dragonet80/MinisumoEdu/README.md

# MinisumoEdu
Robot de minisumo amb finalitats educatives.

De moment, hi ha els arxius en format Eagle de les plaques i les peces en 3D en format Sketchup.

Falten exemples software.
**Pendent de pujar tots els arxius i organitzar-ho tot**
