dragonet80/MinisumoEdu/3D/readme.md

Aquí van els arxius .STL per a imprimir.
Està provat en una Prusa i3 mk3 original.

Dissenys 3D realitzats per Vicent Torres.
