dragonet80/MinisumoEdu/Documents/readme.md

Llistes de materials i col·locació de components a les plaques.
