dragonet80/MinisumoEdu/Documents/Components_placa-base.pdf

Partlist | Placa base
Element | Valor | Tipus
+BAT | 1X02 | Cable JST 2 pin femella
7805 | L7805 | TO-220
AUX1 | 1X03 | Pinhead 2,54mm femella
AUX2 | 1X03 | Pinhead 2,54mm femella
AUX3 | 1X03 | Pinhead 2,54mm femella
AUX4 | 1X03 | Pinhead 2,54mm femella
B1 | Polsador | SMD-6.0X3.5MM
BLUETOOTH1 | 1X04 | Pinhead 2,54mm femella
C1 | 0,33uF | smd 1206
C2 | 0,1uF | smd 1206
C3 | 1mF | pth 6mm electrolític
C4 | 1mF | pth 6mm electrolític
D1 | 1N4148 | smd LL34
GENERAL_SWITCH Interruptor | AYZ0202_TH
J1 | 1X02 | Pinhead 2,54mm 90º mascle
MOTORA | TERMINAL-3.5MM-2 KF-350
MOTORB | TERMINAL-3.5MM-2 KF-350
Q1 | S8050 | TO-92
Q2 | S8050 | TO-92
Q3 | S8050 | TO-92
R1 | 10K | smd 0805
R2 | 22 | smd 0805
R3 | 220 | smd 0805
R4 | 10K | smd 0805
R5 | 6K8 | smd 0805
R6 | 4K7 | smd 0805
R7 | 4K7 | smd 0805
R8 | 220 | smd 0805
R9 | 220 | smd 0805
R10 | 1K | smd 0805
R11 | 2K | smd 0805
SD1 | 1X03 | Pinhead 2,54mm mascle
SD2 | 1X03 | Pinhead 2,54mm mascle
SD3 | 1X03 | Pinhead 2,54mm mascle
SD4 | 1X03 | Pinhead 2,54mm mascle
SD5 | 1X03 | Pinhead 2,54mm mascle
SD6 | 1X03 | Pinhead 2,54mm mascle
SG1 | Buzzer | 12mm
SL1 | 1X03 | Pinhead 2,54mm mascle
SL2 | 1X03 | Pinhead 2,54mm mascle
SL3 | 1X03 | Pinhead 2,54mm mascle
U$1 | Arduino Nano | 2x pinhead 2,54mm femella
U$2 | TB6612FNG | 2x pinhead 2,54mm femella
