dragonet80/MinisumoEdu/Documents/Components_placa-shield.pdf

Partlist | Placa shield
Element | Valor | Tipus
+BAT1 | 1X02 | Cable JST 2 pin femella
+BAT2 | 1X02 | Cable JST 2 pin mascle
AUX5 | 1X03 | Pinhead 2,54mm mascle (25mm)
AUX6 | 1X03 | Pinhead 2,54mm mascle (25mm)
AUX7 | 1X03 | Pinhead 2,54mm mascle (25mm)
AUX8 | 1X03 | Pinhead 2,54mm mascle (25mm)
B1B | Polsador | SMD-6.0X3.5MM
D2 | LED RGB Difús 5mm càtode comú
DISPLAY | 1X04 | Pinhead 2,54mm femella
GENERAL_SWITCH1 | Interruptor | AYZ0202_TH
IMU | 1X04 | Pinhead 2,54mm femella
LEDDFC | VERD | smd 1206
LEDDFD | VERD | smd 1206
LEDDFE | VERD | smd 1206
LEDDLD | VERD | smd 1206
LEDDLE | VERD | smd 1206
LEDDP | VERD | smd 1206
LEDLFD | BLANC | smd 1206
LEDLFE | BLANC | smd 1206
LEDLP | BLANC | smd 1206
MCP23017_INPUTS | 1X10 | *opcional: Pinhead 2,54mm femella
MCP23017_OUTPUTS 2X10 | *opcional: Pinhead 2,54mm femella
R12 | 10K | smd 0805
R13 | 10K | smd 0805
R14 | 10K | smd 0805
R15 | 10K | smd 0805
R16 | 1K | smd 0805
R17 | 1K | smd 0805
R18 | 1K | smd 0805
R19 | 1K | smd 0805
R20 | 1K | smd 0805
R21 | 1K | smd 0805
R22 | 1K | smd 0805
R23 | 1K | smd 0805
R24 | 1K | smd 0805
R25 | 330 | smd 0805
R26 | 330 | smd 0805
R27 | 330 | smd 0805
R28 | 4K7 | smd 0805
R29 | 4K7 | smd 0805
S1 | Polsador | PTH-6.0MM
S2 | Polsador | PTH-6.0MM
S3 | Polsador | PTH-6.0MM
S4 | Polsador | PTH-6.0MM
SERIAL/IR | 1X04 | Pinhead 2,54mm femella
SERVO1 | 1X03 | Pinhead 2,54mm mascle
SERVO2 | 1X03 | Pinhead 2,54mm mascle
SPI | 1X06 | *opcional: Pinhead 2,54mm femella
