dragonet80/MinisumoEdu/Documents/Pressupost_Minisumo_2018_nou.ods

Sheet: Competitiu
Total Robot |  |  | 105,45 €
Component | Preu ud | Quant | COST | Preu x10 | Preu x20 | Preu x100 | Link
SUMA | 6,87 € | 33 | 7,38 € | 57,75 € | 10,41 € | 19,45 €
PCB minisumo | 0,89 € | 1 | 0,89 € | 8,94 € |  |  | https://jlcpcb.com/quote
Arduino nano + cable | 2,99 € | 1 | 2,99 € | 26,13 € |  |  | https://es.aliexpress.com/store/product/Nano-3-0-Mini-controlador-USB-ATmega328-5-V-16-m-tarjeta-del-controlador-Micro-Nano/1326062_32843606477.html | https://es.aliexpress.com/store/product/Wholesale-5pcs-lot-Funduino-Nano-3-0-controller-compatible-with-arduino-nano-Free-Shipping/535576_1307092605.html
Driver TB6612FNG | 1,31 € | 1 | 1,31 € | 13,06 € |  |  | https://es.aliexpress.com/item/Dual-Motor-Driver-TB6612FNG-for-Arduino-Microcontroller-Better-than-L298N-Supporting-self-balanced-car-3PI/32287779353.html
Pins femella 40p | 0,22 € | 2 | 0,43 € |  | 4,32 € |  | https://es.aliexpress.com/store/product/2-54mm-sola-fila-femenino-2-40-p-PCB-Board-socket-Pin-Header-conector-de-Gaza/323553_32869391616.html
Pins mascle 40p negre | 0,18 € | 1 | 0,18 € | 1,77 € |  |  | https://es.aliexpress.com/store/product/30pcs-Pin-Connector-Male-2-54mm-Pitch-Pin-Header-Strip-Single-Row-40-pin-Connector-Kit/1995185_32879595293.html
Pins mascle 40p verm | 0,21 € | 1 | 0,21 € | 2,05 € |  |  | https://es.aliexpress.com/store/product/30pcs-Pin-Connector-Male-2-54mm-Pitch-Pin-Header-Strip-Single-Row-40-pin-Connector-Kit/1995185_32879595293.html
Pins mascle 40p blanc | 0,21 € | 1 | 0,21 € | 2,05 € |  |  | https://es.aliexpress.com/store/product/30pcs-Pin-Connector-Male-2-54mm-Pitch-Pin-Header-Strip-Single-Row-40-pin-Connector-Kit/1995185_32879595293.html
Interruptor 7x7mm | 0,09 € | 1 | 0,09 € |  | 1,82 € |  | https://es.aliexpress.com/store/product/20PCS-7X7mm-6P-Push-Button-Switch-7-7MM-6Pin-Tactile-Power-Micro-Switch-Self-lock-Latching/1390139_32809348405.html | https://es.aliexpress.com/store/product/100PCS-7X7mm-6P-Push-Button-Switch-7-7mm-Tactile-Power-Micro-Non-Locking-Latching-Toys-Flashlight/1390139_32717121474.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
Terminal 3.5mm | 0,12 € | 2 | 0,24 € |  | 2,36 € |  | https://es.aliexpress.com/item/20PCS-LOT-KF301-2P-3P-KF350-2P-3P-KF128-Screw-2Pin-3Pin-5-0mm-Straight-Pin/32889705942.html
Polsador 3x6x4.3mm | 0,02 € | 1 | 0,02 € |  |  | 2,47 € | https://es.aliexpress.com/item/100pcs-lot-SMD-Tact-Switch-Tactile-Switches-connectors-Push-button-3-6-4-3mm/32310218338.html
Regulador 7805 | 0,17 € | 1 | 0,17 € | 1,73 € |  |  | https://es.aliexpress.com/store/product/Free-Shipping-50PCS-IC-L7805CV-L7805-7805-Voltage-Regulator-5V-1-5A-TO-220/604366_1936084347.html
Diode 1N4148 | 0,01 € | 1 | 0,01 € |  |  | 1,34 € | https://es.aliexpress.com/store/product/Free-shipping-100PCS-SMD-1N4148-LL4148-4148-LL34-switching-diode/511081_793795951.html
Transistor NPN S8050 | 0,01 € | 3 | 0,04 € |  |  | 1,43 € | https://es.aliexpress.com/store/product/100pcs-Transistor-S8050-D331-NPN-TO92-Package-new/511081_32429477379.html
Buzzer 12mm 5V | 0,20 € | 1 | 0,20 € | 2,02 € |  |  | https://es.aliexpress.com/store/product/10-piezas-5-V-activa-zumbador-tono-continuo-magn-tico-alarma-del-12mm-MINI-Active-Piezo/1266255_32914327679.html
Condensador 100nF | 0,03 € | 1 | 0,03 € |  |  | 2,53 € | https://es.aliexpress.com/store/product/100-piezas-100NF-X7R-Error-10-50-V-0-1-UF-104-1206-smd-del-env/2885226_32905749589.html
Condensador 330nF | 0,03 € | 1 | 0,03 € |  |  | 2,83 € | https://es.aliexpress.com/store/product/100-piezas-1206-condensador-330NF-470NF-1-UF-2-2-UF-4-7-UF-50-V/1711463_32879068458.html
Condensador 16V1mF | 0,10 € | 2 | 0,19 € |  | 1,91 € |  | https://es.aliexpress.com/store/product/10v-1000UF-8-9aluminum-electrolytic-capacitor-1000uf-10v/826019_32814611460.html
Resistencia 22 | 0,01 € | 1 | 0,01 € |  |  | 1,26 € | https://es.aliexpress.com/store/product/500Pcs-2012-Chip-resistor-1-4w-0805-5-0R-1-2-2-3-3-4-7/821060_32817289197.html
Resistencia 220 | 0,01 € | 3 | 0,04 € |  |  | 1,26 € | https://es.aliexpress.com/store/product/500Pcs-2012-Chip-resistor-1-4w-0805-5-0R-1-2-2-3-3-4-7/821060_32817289197.html
Resistencia 1K | 0,01 € | 1 | 0,01 € |  |  | 1,26 € | https://es.aliexpress.com/store/product/0805-SMD-Resistors-10k-10K-ohm-1-8W-5-0805-SMD-Resistors-0805-Chip-resistor-500pcs/821060_852348196.html
Resistencia 2K | 0,01 € | 1 | 0,01 € |  |  | 1,26 € | https://es.aliexpress.com/store/product/0805-SMD-Resistors-10k-10K-ohm-1-8W-5-0805-SMD-Resistors-0805-Chip-resistor-500pcs/821060_852348196.html
Resistencia 4K7 | 0,01 € | 2 | 0,03 € |  |  | 1,26 € | https://es.aliexpress.com/store/product/0805-SMD-Resistors-10k-10K-ohm-1-8W-5-0805-SMD-Resistors-0805-Chip-resistor-500pcs/821060_852348196.html
Resistencia 6K8 | 0,01 € | 1 | 0,01 € |  |  | 1,26 € | https://es.aliexpress.com/store/product/0805-SMD-Resistors-10k-10K-ohm-1-8W-5-0805-SMD-Resistors-0805-Chip-resistor-500pcs/821060_852348196.html
Resistencia 10K | 0,01 € | 2 | 0,03 € |  |  | 1,26 € | https://es.aliexpress.com/store/product/0805-SMD-Resistors-10k-10K-ohm-1-8W-5-0805-SMD-Resistors-0805-Chip-resistor-500pcs/821060_852348196.html
Component | Preu ud | Quant | COST | Preu x10 | Preu x20 | Preu x100 | Link
SUMA | 4,38 € | 45 | 4,72 € | 38,86 € | 6,94 € | 14,92 €
PCB shield | - € | 1 | - € | - € |  |  | https://jlcpcb.com/quote
Polsador 3x6x4.3mm | 0,02 € | 1 | 0,02 € |  |  | 2,47 € | https://es.aliexpress.com/item/100pcs-lot-SMD-Tact-Switch-Tactile-Switches-connectors-Push-button-3-6-4-3mm/32310218338.html
Pins femella 40p | 0,22 € | 1 | 0,22 € |  | 4,32 € |  | https://es.aliexpress.com/store/product/2-54mm-sola-fila-femenino-2-40-p-PCB-Board-socket-Pin-Header-conector-de-Gaza/323553_32869391616.html
Pins mascle 40p negre | 0,18 € | 1 | 0,18 € | 1,77 € |  |  | https://es.aliexpress.com/store/product/30pcs-Pin-Connector-Male-2-54mm-Pitch-Pin-Header-Strip-Single-Row-40-pin-Connector-Kit/1995185_32879595293.html
Pins mascle 40p verm | 0,21 € | 1 | 0,21 € | 2,05 € |  |  | https://es.aliexpress.com/store/product/30pcs-Pin-Connector-Male-2-54mm-Pitch-Pin-Header-Strip-Single-Row-40-pin-Connector-Kit/1995185_32879595293.html
Pins mascle 40p blanc | 0,21 € | 1 | 0,21 € | 2,05 € |  |  | https://es.aliexpress.com/store/product/30pcs-Pin-Connector-Male-2-54mm-Pitch-Pin-Header-Strip-Single-Row-40-pin-Connector-Kit/1995185_32879595293.html
Pins mascle 40p 30mm | 0,43 € | 1 | 0,43 € | 4,32 € |  |  | https://es.aliexpress.com/item/2-54mm-macho-de-una-fila-1-40-p-Breakaway-PCB-Pin-Header-largo-11-15/32891470557.html
Polsador 6x6x6mm | 0,04 € | 4 | 0,14 € |  |  | 3,62 € | https://es.aliexpress.com/store/product/100pcs-8-Type-6mm-6mm-4Pin-Vertical-Tact-Switch-6x6mm-4P-Micro-Push-Button-Tactile-Switchs/1390139_32715988094.html
Interruptor 7x7mm | 0,09 € | 1 | 0,09 € |  | 1,82 € |  | https://es.aliexpress.com/store/product/20PCS-7X7mm-6P-Push-Button-Switch-7-7MM-6Pin-Tactile-Power-Micro-Switch-Self-lock-Latching/1390139_32809348405.html | https://es.aliexpress.com/store/product/100PCS-7X7mm-6P-Push-Button-Switch-7-7mm-Tactile-Power-Micro-Non-Locking-Latching-Toys-Flashlight/1390139_32717121474.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
Resistencia 0R | 0,01 € | 3 | 0,04 € |  |  | 1,26 € | https://es.aliexpress.com/store/product/500Pcs-2012-Chip-resistor-1-4w-0805-5-0R-1-2-2-3-3-4-7/821060_32817289197.html
Resistencia 330 | 0,01 € | 3 | 0,04 € |  |  | 1,26 € | https://es.aliexpress.com/store/product/500Pcs-2012-Chip-resistor-1-4w-0805-5-0R-1-2-2-3-3-4-7/821060_32817289197.html
Resistencia 1K | 0,01 € | 9 | 0,11 € |  |  | 1,26 € | https://es.aliexpress.com/store/product/0805-SMD-Resistors-10k-10K-ohm-1-8W-5-0805-SMD-Resistors-0805-Chip-resistor-500pcs/821060_852348196.html
Resistencia 4K7 | 0,01 € | 2 | 0,03 € |  |  | 1,26 € | https://es.aliexpress.com/store/product/0805-SMD-Resistors-10k-10K-ohm-1-8W-5-0805-SMD-Resistors-0805-Chip-resistor-500pcs/821060_852348196.html
Resistencia 10K | 0,01 € | 4 | 0,05 € |  |  | 1,26 € | https://es.aliexpress.com/store/product/0805-SMD-Resistors-10k-10K-ohm-1-8W-5-0805-SMD-Resistors-0805-Chip-resistor-500pcs/821060_852348196.html
LED 1206 verm | 0,01 € | 1 | 0,01 € |  |  | 0,65 € | https://es.aliexpress.com/item/100PCS-Free-Shipping-1206-red-light-light-emitting-diode-SMD-LED-3216-Diodes-SMD-1206-led/32366957683.html
LED 1206 verd | 0,01 € | 3 | 0,02 € |  |  | 0,55 € | https://es.aliexpress.com/item/100PCS-Free-Shipping-SMD-1206-Green-Led-1206-SMD-LED-Green-super-bright-1206-light-emitting/32367349756.html
LED 1206 blau | 0,01 € | 2 | 0,01 € |  |  | 0,66 € | https://es.aliexpress.com/item/100PCS-Free-Shipping-1206-Blue-Led-Super-Bright-SMD-LED-diodes-3-2-1-6-0/32369344670.html
LED 1206 blanc | 0,01 € | 3 | 0,02 € |  |  | 0,66 € | https://es.aliexpress.com/item/100PCS-SMD-1206-White-Led-Free-Shipping-1206-smd-led-cool-white-Super-Bright-LED-Diode/32368682563.html
LED RGB 5mm | 0,04 € | 1 | 0,04 € |  | 0,80 € |  | https://es.aliexpress.com/item/20pcs-5mm-RGB-LED-Common-Cathode-Tri-Color-Emitting-Diodes-f5-RGB-Diffused-5mm-led-red/32666259962.html
Display 0.96" | 1,94 € | 1 | 1,94 € | 19,39 € |  |  | https://es.aliexpress.com/store/product/10pcs-0-96-blue-0-96-inch-OLED-module-New-128X64-OLED-LCD-LED-Display-Module/1022067_32640619833.html
Expansor pins mcp23017 | 0,93 € | 1 | 0,93 € | 9,28 € |  |  | https://es.aliexpress.com/store/product/MCP23017-Serial-Interface-Module-IIC-I2C-SPI-MCP23S17-Bidirectional-16-Bit-I-O-Expander-Pins-10Mhz/1185416_32830799627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
Component | Preu ud | Quant | COST | Preu x10 | Preu x20 | Preu x100 | Link
SUMA | 56,12 € | 12 | 93,36 € | - € | 264,75 € | - €
Rodes minisumo 33x20 | 13,00 € | 1 | 13,00 € |  |  |  | http://www.jsumo.com/slt20p-steel-silicone-wheel-set-33mm-x-20mm-pair
Sensor línia | 2,00 € | 3 | 6,00 € |  |  |  | http://www.jsumo.com/micro-line-sensor-ml1
Sensor distància | 10,00 € | 3 | 30,00 € |  |  |  | http://www.jsumo.com/js40f-digital-distance-sensor-min-40-cm-range
Start module | 5,50 € | 1 | 5,50 € |  |  |  | http://www.jsumo.com/microstart-sumo-minisumo-robot-start-module
Bateria 2S 850mAh | 5,77 € | 1 | 5,77 € |  |  |  | https://hobbyking.com/es_es/turnigy-nano-tech-850mah-2s-25-40c-lipo-pack.html
Carregador bateries | 6,61 € | 1 | 6,61 € |  |  |  | https://hobbyking.com/es_es/hobbykingr-b3ac-compact-charger-eu-plug.html
Motors Pololu 1:50 | 13,24 € | 2 | 26,48 € |  | 264,75 € |  | https://www.pololu.com/product/2213

Sheet: Barat
Total Robot |  |  | 43,28 €
Component | Preu ud | Quant | COST | Preu x10 | Preu x20 | Preu x100 | Link
SUMA | 6,87 € | 33 | 7,38 € | 57,75 € | 10,41 € | 19,45 €
PCB minisumo | 0,89 € | 1 | 0,89 € | 8,94 € |  |  | https://jlcpcb.com/quote
Arduino nano + cable | 2,99 € | 1 | 2,99 € | 26,13 € |  |  | https://es.aliexpress.com/store/product/Nano-3-0-Mini-controlador-USB-ATmega328-5-V-16-m-tarjeta-del-controlador-Micro-Nano/1326062_32843606477.html | https://es.aliexpress.com/store/product/Wholesale-5pcs-lot-Funduino-Nano-3-0-controller-compatible-with-arduino-nano-Free-Shipping/535576_1307092605.html
Driver TB6612FNG | 1,31 € | 1 | 1,31 € | 13,06 € |  |  | https://es.aliexpress.com/item/Dual-Motor-Driver-TB6612FNG-for-Arduino-Microcontroller-Better-than-L298N-Supporting-self-balanced-car-3PI/32287779353.html
Pins femella 40p | 0,22 € | 2 | 0,43 € |  | 4,32 € |  | https://es.aliexpress.com/store/product/2-54mm-sola-fila-femenino-2-40-p-PCB-Board-socket-Pin-Header-conector-de-Gaza/323553_32869391616.html
Pins mascle 40p negre | 0,18 € | 1 | 0,18 € | 1,77 € |  |  | https://es.aliexpress.com/store/product/30pcs-Pin-Connector-Male-2-54mm-Pitch-Pin-Header-Strip-Single-Row-40-pin-Connector-Kit/1995185_32879595293.html
Pins mascle 40p verm | 0,21 € | 1 | 0,21 € | 2,05 € |  |  | https://es.aliexpress.com/store/product/30pcs-Pin-Connector-Male-2-54mm-Pitch-Pin-Header-Strip-Single-Row-40-pin-Connector-Kit/1995185_32879595293.html
Pins mascle 40p blanc | 0,21 € | 1 | 0,21 € | 2,05 € |  |  | https://es.aliexpress.com/store/product/30pcs-Pin-Connector-Male-2-54mm-Pitch-Pin-Header-Strip-Single-Row-40-pin-Connector-Kit/1995185_32879595293.html
Interruptor 7x7mm | 0,09 € | 1 | 0,09 € |  | 1,82 € |  | https://es.aliexpress.com/store/product/20PCS-7X7mm-6P-Push-Button-Switch-7-7MM-6Pin-Tactile-Power-Micro-Switch-Self-lock-Latching/1390139_32809348405.html | https://es.aliexpress.com/store/product/100PCS-7X7mm-6P-Push-Button-Switch-7-7mm-Tactile-Power-Micro-Non-Locking-Latching-Toys-Flashlight/1390139_32717121474.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
Terminal 3.5mm | 0,12 € | 2 | 0,24 € |  | 2,36 € |  | https://es.aliexpress.com/item/20PCS-LOT-KF301-2P-3P-KF350-2P-3P-KF128-Screw-2Pin-3Pin-5-0mm-Straight-Pin/32889705942.html
Polsador 3x6x4.3mm | 0,02 € | 1 | 0,02 € |  |  | 2,47 € | https://es.aliexpress.com/item/100pcs-lot-SMD-Tact-Switch-Tactile-Switches-connectors-Push-button-3-6-4-3mm/32310218338.html
Regulador 7805 | 0,17 € | 1 | 0,17 € | 1,73 € |  |  | https://es.aliexpress.com/store/product/Free-Shipping-50PCS-IC-L7805CV-L7805-7805-Voltage-Regulator-5V-1-5A-TO-220/604366_1936084347.html
Transistor NPN S8050 | 0,01 € | 3 | 0,04 € |  |  | 1,43 € | https://es.aliexpress.com/store/product/100pcs-Transistor-S8050-D331-NPN-TO92-Package-new/511081_32429477379.html
Diode 1N4148 | 0,01 € | 1 | 0,01 € |  |  | 1,34 € | https://es.aliexpress.com/store/product/Free-shipping-100PCS-SMD-1N4148-LL4148-4148-LL34-switching-diode/511081_793795951.html
Buzzer 12mm 5V | 0,20 € | 1 | 0,20 € | 2,02 € |  |  | https://es.aliexpress.com/store/product/10-piezas-5-V-activa-zumbador-tono-continuo-magn-tico-alarma-del-12mm-MINI-Active-Piezo/1266255_32914327679.html
Condensador 100nF | 0,03 € | 1 | 0,03 € |  |  | 2,53 € | https://es.aliexpress.com/store/product/100-piezas-100NF-X7R-Error-10-50-V-0-1-UF-104-1206-smd-del-env/2885226_32905749589.html
Condensador 330nF | 0,03 € | 1 | 0,03 € |  |  | 2,83 € | https://es.aliexpress.com/store/product/100-piezas-1206-condensador-330NF-470NF-1-UF-2-2-UF-4-7-UF-50-V/1711463_32879068458.html
Condensador 16V1mF | 0,10 € | 2 | 0,19 € |  | 1,91 € |  | https://es.aliexpress.com/store/product/10v-1000UF-8-9aluminum-electrolytic-capacitor-1000uf-10v/826019_32814611460.html
Resistencia 22 | 0,01 € | 1 | 0,01 € |  |  | 1,26 € | https://es.aliexpress.com/store/product/500Pcs-2012-Chip-resistor-1-4w-0805-5-0R-1-2-2-3-3-4-7/821060_32817289197.html
Resistencia 220 | 0,01 € | 3 | 0,04 € |  |  | 1,26 € | https://es.aliexpress.com/store/product/500Pcs-2012-Chip-resistor-1-4w-0805-5-0R-1-2-2-3-3-4-7/821060_32817289197.html
Resistencia 1K | 0,01 € | 1 | 0,01 € |  |  | 1,26 € | https://es.aliexpress.com/store/product/0805-SMD-Resistors-10k-10K-ohm-1-8W-5-0805-SMD-Resistors-0805-Chip-resistor-500pcs/821060_852348196.html
Resistencia 2K | 0,01 € | 1 | 0,01 € |  |  | 1,26 € | https://es.aliexpress.com/store/product/0805-SMD-Resistors-10k-10K-ohm-1-8W-5-0805-SMD-Resistors-0805-Chip-resistor-500pcs/821060_852348196.html
Resistencia 4K7 | 0,01 € | 2 | 0,03 € |  |  | 1,26 € | https://es.aliexpress.com/store/product/0805-SMD-Resistors-10k-10K-ohm-1-8W-5-0805-SMD-Resistors-0805-Chip-resistor-500pcs/821060_852348196.html
Resistencia 6K8 | 0,01 € | 1 | 0,01 € |  |  | 1,26 € | https://es.aliexpress.com/store/product/0805-SMD-Resistors-10k-10K-ohm-1-8W-5-0805-SMD-Resistors-0805-Chip-resistor-500pcs/821060_852348196.html
Resistencia 10K | 0,01 € | 2 | 0,03 € |  |  | 1,26 € | https://es.aliexpress.com/store/product/0805-SMD-Resistors-10k-10K-ohm-1-8W-5-0805-SMD-Resistors-0805-Chip-resistor-500pcs/821060_852348196.html
Component | Preu ud | Quant | COST | Preu x10 | Preu x20 | Preu x100 | Link
SUMA | 4,38 € | 45 | 4,72 € | 38,86 € | 6,94 € | 14,92 €
PCB shield | - € | 1 | - € | - € |  |  | https://jlcpcb.com/quote
Polsador 3x6x4.3mm | 0,02 € | 1 | 0,02 € |  |  | 2,47 € | https://es.aliexpress.com/item/100pcs-lot-SMD-Tact-Switch-Tactile-Switches-connectors-Push-button-3-6-4-3mm/32310218338.html
Pins femella 40p | 0,22 € | 1 | 0,22 € |  | 4,32 € |  | https://es.aliexpress.com/store/product/2-54mm-sola-fila-femenino-2-40-p-PCB-Board-socket-Pin-Header-conector-de-Gaza/323553_32869391616.html
Pins mascle 40p negre | 0,18 € | 1 | 0,18 € | 1,77 € |  |  | https://es.aliexpress.com/store/product/30pcs-Pin-Connector-Male-2-54mm-Pitch-Pin-Header-Strip-Single-Row-40-pin-Connector-Kit/1995185_32879595293.html
Pins mascle 40p verm | 0,21 € | 1 | 0,21 € | 2,05 € |  |  | https://es.aliexpress.com/store/product/30pcs-Pin-Connector-Male-2-54mm-Pitch-Pin-Header-Strip-Single-Row-40-pin-Connector-Kit/1995185_32879595293.html
Pins mascle 40p blanc | 0,21 € | 1 | 0,21 € | 2,05 € |  |  | https://es.aliexpress.com/store/product/30pcs-Pin-Connector-Male-2-54mm-Pitch-Pin-Header-Strip-Single-Row-40-pin-Connector-Kit/1995185_32879595293.html
Pins mascle 40p 30mm | 0,43 € | 1 | 0,43 € | 4,32 € |  |  | https://es.aliexpress.com/item/2-54mm-macho-de-una-fila-1-40-p-Breakaway-PCB-Pin-Header-largo-11-15/32891470557.html
Polsador 6x6x6mm | 0,04 € | 4 | 0,14 € |  |  | 3,62 € | https://es.aliexpress.com/store/product/100pcs-8-Type-6mm-6mm-4Pin-Vertical-Tact-Switch-6x6mm-4P-Micro-Push-Button-Tactile-Switchs/1390139_32715988094.html
Interruptor 7x7mm | 0,09 € | 1 | 0,09 € |  | 1,82 € |  | https://es.aliexpress.com/store/product/20PCS-7X7mm-6P-Push-Button-Switch-7-7MM-6Pin-Tactile-Power-Micro-Switch-Self-lock-Latching/1390139_32809348405.html | https://es.aliexpress.com/store/product/100PCS-7X7mm-6P-Push-Button-Switch-7-7mm-Tactile-Power-Micro-Non-Locking-Latching-Toys-Flashlight/1390139_32717121474.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
Resistencia 0R | 0,01 € | 3 | 0,04 € |  |  | 1,26 € | https://es.aliexpress.com/store/product/500Pcs-2012-Chip-resistor-1-4w-0805-5-0R-1-2-2-3-3-4-7/821060_32817289197.html
Resistencia 330 | 0,01 € | 3 | 0,04 € |  |  | 1,26 € | https://es.aliexpress.com/store/product/500Pcs-2012-Chip-resistor-1-4w-0805-5-0R-1-2-2-3-3-4-7/821060_32817289197.html
Resistencia 1K | 0,01 € | 9 | 0,11 € |  |  | 1,26 € | https://es.aliexpress.com/store/product/0805-SMD-Resistors-10k-10K-ohm-1-8W-5-0805-SMD-Resistors-0805-Chip-resistor-500pcs/821060_852348196.html
Resistencia 4K7 | 0,01 € | 2 | 0,03 € |  |  | 1,26 € | https://es.aliexpress.com/store/product/0805-SMD-Resistors-10k-10K-ohm-1-8W-5-0805-SMD-Resistors-0805-Chip-resistor-500pcs/821060_852348196.html
Resistencia 10K | 0,01 € | 4 | 0,05 € |  |  | 1,26 € | https://es.aliexpress.com/store/product/0805-SMD-Resistors-10k-10K-ohm-1-8W-5-0805-SMD-Resistors-0805-Chip-resistor-500pcs/821060_852348196.html
LED 1206 verm | 0,01 € | 1 | 0,01 € |  |  | 0,65 € | https://es.aliexpress.com/store/product/100-unids-lote-3216-1206-SMD-Led-Super-brillante-rojo-Verde-azul-agua-clara-luz-LED/1326062_32889348579.html
LED 1206 verd | 0,01 € | 3 | 0,02 € |  |  | 0,55 € | https://es.aliexpress.com/store/product/100-unids-lote-3216-1206-SMD-Led-Super-brillante-rojo-Verde-azul-agua-clara-luz-LED/1326062_32889348579.html
LED 1206 blau | 0,01 € | 2 | 0,01 € |  |  | 0,66 € | https://es.aliexpress.com/store/product/100-unids-lote-3216-1206-SMD-Led-Super-brillante-rojo-Verde-azul-agua-clara-luz-LED/1326062_32889348579.html
LED 1206 blanc | 0,01 € | 3 | 0,02 € |  |  | 0,66 € | https://es.aliexpress.com/store/product/100PCS-SMD-1206-White-Led-Free-Shipping-1206-smd-led-cool-white-Super-Bright-LED-Diode/1758868_32368682563.html
LED RGB 5mm | 0,04 € | 1 | 0,04 € |  | 0,80 € |  | https://es.aliexpress.com/store/product/20pcs-5mm-RGB-LED-Common-Cathode-Tri-Color-Emitting-Diodes-f5-RGB-Diffused-5mm-led-red/1758868_32666259962.html
Display 0.96" | 1,94 € | 1 | 1,94 € | 19,39 € |  |  | https://es.aliexpress.com/store/product/10pcs-0-96-blue-0-96-inch-OLED-module-New-128X64-OLED-LCD-LED-Display-Module/1022067_32640619833.html
Expansor pins mcp23017 | 0,93 € | 1 | 0,93 € | 9,28 € |  |  | https://es.aliexpress.com/store/product/MCP23017-Serial-Interface-Module-IIC-I2C-SPI-MCP23S17-Bidirectional-16-Bit-I-O-Expander-Pins-10Mhz/1185416_32830799627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
Component | Preu ud | Quant | COST | Preu x10 | Preu x20 | Preu x100 | Link
SUMA | 23,26 € | 13 | 31,18 € | - € | 56,84 € | - €
Rodes minisumo 33x20 | 0,66 € | 2 | 1,31 € |  | 13,14 € |  | https://es.aliexpress.com/store/product/10-piezas-K346-43-19-3mm-d-hole-caucho-rueda-conveniente-para-N20-Motor-D-eje/1965526_32891298768.html
Sensor línia | 2,00 € | 3 | 6,00 € |  |  |  | http://www.jsumo.com/micro-line-sensor-ml1
Sensor distància | 0,54 € | 3 | 1,62 € |  |  |  | https://es.aliexpress.com/item/Smart-Electronics-New-for-Arduino-Diy-Smart-Car-Robot-Reflective-Photoelectric-3pin-IR-Infrared-Obstacle-Avoidance/32461659104.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
Start module | 5,50 € | 1 | 5,50 € |  |  |  | http://www.jsumo.com/microstart-sumo-minisumo-robot-start-module
Bateria 2S 850mAh | 5,77 € | 1 | 5,77 € |  |  |  | https://hobbyking.com/es_es/turnigy-nano-tech-850mah-2s-25-40c-lipo-pack.html
Carregador bateries | 6,61 € | 1 | 6,61 € |  |  |  | https://hobbyking.com/es_es/hobbykingr-b3ac-compact-charger-eu-plug.html
Motors Pololu 1:50 | 2,19 € | 2 | 4,37 € |  | 43,70 € |  | https://www.aliexpress.com/item/12MM-6V-300RPM-Powerful-High-Torque-DC-Gear-Box-Motor/32277738334.html

Sheet: Barat_(2)
 | Total Robot |  |  | 43,28 €
 | Quantitat robots | 30 |  |  |  | 1.043,13 €
 | Component | Preu ud | Qt | COST | Qt real | Total | Preu x10 | Preu x20 | Preu x100 | Link
 | SUMA | 6,87 € | 33 | 7,38 € | 990 | 221,27 € | 57,75 € | 10,41 € | 19,45 €
30 | PCB minisumo | 0,89 € | 1 | 0,89 € | 30,00 | 26,82 € | 8,94 € |  |  | https://jlcpcb.com/quote
30 | Arduino nano + cable | 2,99 € | 1 | 2,99 € | 30,00 | 89,70 € | 26,13 € |  |  | https://es.aliexpress.com/store/product/Nano-3-0-Mini-controlador-USB-ATmega328-5-V-16-m-tarjeta-del-controlador-Micro-Nano/1326062_32843606477.html | https://es.aliexpress.com/store/product/Wholesale-5pcs-lot-Funduino-Nano-3-0-controller-compatible-with-arduino-nano-Free-Shipping/535576_1307092605.html
30 | Driver TB6612FNG | 1,31 € | 1 | 1,31 € | 30,00 | 39,18 € | 13,06 € |  |  | https://es.aliexpress.com/item/Dual-Motor-Driver-TB6612FNG-for-Arduino-Microcontroller-Better-than-L298N-Supporting-self-balanced-car-3PI/32287779353.html
 | Pins femella 40p | 0,22 € | 2 | 0,43 € | 60,00 | 12,96 € |  | 4,32 € |  | https://es.aliexpress.com/store/product/2-54mm-sola-fila-femenino-2-40-p-PCB-Board-socket-Pin-Header-conector-de-Gaza/323553_32869391616.html
 | Pins mascle 40p negre | 0,18 € | 1 | 0,18 € | 30,00 | 5,31 € | 1,77 € |  |  | https://es.aliexpress.com/store/product/30pcs-Pin-Connector-Male-2-54mm-Pitch-Pin-Header-Strip-Single-Row-40-pin-Connector-Kit/1995185_32879595293.html
 | Pins mascle 40p verm | 0,21 € | 1 | 0,21 € | 30,00 | 6,15 € | 2,05 € |  |  | https://es.aliexpress.com/store/product/30pcs-Pin-Connector-Male-2-54mm-Pitch-Pin-Header-Strip-Single-Row-40-pin-Connector-Kit/1995185_32879595293.html
 | Pins mascle 40p blanc | 0,21 € | 1 | 0,21 € | 30,00 | 6,15 € | 2,05 € |  |  | https://es.aliexpress.com/store/product/30pcs-Pin-Connector-Male-2-54mm-Pitch-Pin-Header-Strip-Single-Row-40-pin-Connector-Kit/1995185_32879595293.html
 | Interruptor 7x7mm | 0,09 € | 1 | 0,09 € | 30,00 | 2,73 € |  | 1,82 € |  | https://es.aliexpress.com/store/product/20PCS-7X7mm-6P-Push-Button-Switch-7-7MM-6Pin-Tactile-Power-Micro-Switch-Self-lock-Latching/1390139_32809348405.html | https://es.aliexpress.com/store/product/100PCS-7X7mm-6P-Push-Button-Switch-7-7mm-Tactile-Power-Micro-Non-Locking-Latching-Toys-Flashlight/1390139_32717121474.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
 | Terminal 3.5mm | 0,12 € | 2 | 0,24 € | 60,00 | 7,08 € |  | 2,36 € |  | https://es.aliexpress.com/item/20PCS-LOT-KF301-2P-3P-KF350-2P-3P-KF128-Screw-2Pin-3Pin-5-0mm-Straight-Pin/32889705942.html
 | Polsador 3x6x4.3mm | 0,02 € | 1 | 0,02 € | 30,00 | 0,74 € |  |  | 2,47 € | https://es.aliexpress.com/item/100pcs-lot-SMD-Tact-Switch-Tactile-Switches-connectors-Push-button-3-6-4-3mm/32310218338.html
 | Regulador 7805 | 0,17 € | 1 | 0,17 € | 30,00 | 5,19 € | 1,73 € |  |  | https://es.aliexpress.com/store/product/Free-Shipping-50PCS-IC-L7805CV-L7805-7805-Voltage-Regulator-5V-1-5A-TO-220/604366_1936084347.html
 | Transistor NPN S8050 | 0,01 € | 3 | 0,04 € | 90,00 | 1,29 € |  |  | 1,43 € | https://es.aliexpress.com/store/product/100pcs-Transistor-S8050-D331-NPN-TO92-Package-new/511081_32429477379.html
 | Diode 1N4148 | 0,01 € | 1 | 0,01 € | 30,00 | 0,40 € |  |  | 1,34 € | https://es.aliexpress.com/store/product/Free-shipping-100PCS-SMD-1N4148-LL4148-4148-LL34-switching-diode/511081_793795951.html
 | Buzzer 12mm 5V | 0,20 € | 1 | 0,20 € | 30,00 | 6,06 € | 2,02 € |  |  | https://es.aliexpress.com/store/product/10-piezas-5-V-activa-zumbador-tono-continuo-magn-tico-alarma-del-12mm-MINI-Active-Piezo/1266255_32914327679.html
 | Condensador 100nF | 0,03 € | 1 | 0,03 € | 30,00 | 0,76 € |  |  | 2,53 € | https://es.aliexpress.com/store/product/100-piezas-100NF-X7R-Error-10-50-V-0-1-UF-104-1206-smd-del-env/2885226_32905749589.html
 | Condensador 330nF | 0,03 € | 1 | 0,03 € | 30,00 | 0,85 € |  |  | 2,83 € | https://es.aliexpress.com/store/product/100-piezas-1206-condensador-330NF-470NF-1-UF-2-2-UF-4-7-UF-50-V/1711463_32879068458.html
60 | Condensador 16V1mF | 0,10 € | 2 | 0,19 € | 60,00 | 5,73 € |  | 1,91 € |  | https://es.aliexpress.com/store/product/10v-1000UF-8-9aluminum-electrolytic-capacitor-1000uf-10v/826019_32814611460.html
 | Resistencia 22 | 0,01 € | 1 | 0,01 € | 30,00 | 0,38 € |  |  | 1,26 € | https://es.aliexpress.com/store/product/500Pcs-2012-Chip-resistor-1-4w-0805-5-0R-1-2-2-3-3-4-7/821060_32817289197.html
 | Resistencia 220 | 0,01 € | 3 | 0,04 € | 90,00 | 1,14 € |  |  | 1,26 € | https://es.aliexpress.com/store/product/500Pcs-2012-Chip-resistor-1-4w-0805-5-0R-1-2-2-3-3-4-7/821060_32817289197.html
 | Resistencia 1K | 0,01 € | 1 | 0,01 € | 30,00 | 0,38 € |  |  | 1,26 € | https://es.aliexpress.com/store/product/0805-SMD-Resistors-10k-10K-ohm-1-8W-5-0805-SMD-Resistors-0805-Chip-resistor-500pcs/821060_852348196.html
 | Resistencia 2K | 0,01 € | 1 | 0,01 € | 30,00 | 0,38 € |  |  | 1,26 € | https://es.aliexpress.com/store/product/0805-SMD-Resistors-10k-10K-ohm-1-8W-5-0805-SMD-Resistors-0805-Chip-resistor-500pcs/821060_852348196.html
 | Resistencia 4K7 | 0,01 € | 2 | 0,03 € | 60,00 | 0,76 € |  |  | 1,26 € | https://es.aliexpress.com/store/product/0805-SMD-Resistors-10k-10K-ohm-1-8W-5-0805-SMD-Resistors-0805-Chip-resistor-500pcs/821060_852348196.html
 | Resistencia 6K8 | 0,01 € | 1 | 0,01 € | 30,00 | 0,38 € |  |  | 1,26 € | https://es.aliexpress.com/store/product/0805-SMD-Resistors-10k-10K-ohm-1-8W-5-0805-SMD-Resistors-0805-Chip-resistor-500pcs/821060_852348196.html
 | Resistencia 10K | 0,01 € | 2 | 0,03 € | 60,00 | 0,76 € |  |  | 1,26 € | https://es.aliexpress.com/store/product/0805-SMD-Resistors-10k-10K-ohm-1-8W-5-0805-SMD-Resistors-0805-Chip-resistor-500pcs/821060_852348196.html
 | Component | Preu ud | Qt | COST |  |  | Preu x10 | Preu x20 | Preu x100 | Link
 | SUMA | 4,38 € | 45 | 4,72 € | 1230 | 124,09 € | 38,86 € | 6,94 € | 14,92 €
 | PCB shield | - € | 1 | - € |  | - € | - € |  |  | https://jlcpcb.com/quote
 | Polsador 3x6x4.3mm | 0,02 € | 1 | 0,02 € | 30,00 | 0,74 € |  |  | 2,47 € | https://es.aliexpress.com/item/100pcs-lot-SMD-Tact-Switch-Tactile-Switches-connectors-Push-button-3-6-4-3mm/32310218338.html
 | Pins femella 40p | 0,22 € | 1 | 0,22 € | 30,00 | 6,48 € |  | 4,32 € |  | https://es.aliexpress.com/store/product/2-54mm-sola-fila-femenino-2-40-p-PCB-Board-socket-Pin-Header-conector-de-Gaza/323553_32869391616.html
 | Pins mascle 40p negre | 0,18 € | 1 | 0,18 € |  | - € | 1,77 € |  |  | https://es.aliexpress.com/store/product/30pcs-Pin-Connector-Male-2-54mm-Pitch-Pin-Header-Strip-Single-Row-40-pin-Connector-Kit/1995185_32879595293.html
 | Pins mascle 40p verm | 0,21 € | 1 | 0,21 € |  | - € | 2,05 € |  |  | https://es.aliexpress.com/store/product/30pcs-Pin-Connector-Male-2-54mm-Pitch-Pin-Header-Strip-Single-Row-40-pin-Connector-Kit/1995185_32879595293.html
 | Pins mascle 40p blanc | 0,21 € | 1 | 0,21 € |  | - € | 2,05 € |  |  | https://es.aliexpress.com/store/product/30pcs-Pin-Connector-Male-2-54mm-Pitch-Pin-Header-Strip-Single-Row-40-pin-Connector-Kit/1995185_32879595293.html
 | Pins mascle 40p 30mm | 0,43 € | 1 | 0,43 € | 30,00 | 12,96 € | 4,32 € |  |  | https://es.aliexpress.com/item/2-54mm-macho-de-una-fila-1-40-p-Breakaway-PCB-Pin-Header-largo-11-15/32891470557.html
 | Polsador 6x6x6mm | 0,04 € | 4 | 0,14 € | 120,00 | 4,34 € |  |  | 3,62 € | https://es.aliexpress.com/store/product/100pcs-8-Type-6mm-6mm-4Pin-Vertical-Tact-Switch-6x6mm-4P-Micro-Push-Button-Tactile-Switchs/1390139_32715988094.html
 | Interruptor 7x7mm | 0,09 € | 1 | 0,09 € | 30,00 | 2,73 € |  | 1,82 € |  | https://es.aliexpress.com/store/product/20PCS-7X7mm-6P-Push-Button-Switch-7-7MM-6Pin-Tactile-Power-Micro-Switch-Self-lock-Latching/1390139_32809348405.html | https://es.aliexpress.com/store/product/100PCS-7X7mm-6P-Push-Button-Switch-7-7mm-Tactile-Power-Micro-Non-Locking-Latching-Toys-Flashlight/1390139_32717121474.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
 | Resistencia 0R | 0,01 € | 3 | 0,04 € | 90,00 | 1,14 € |  |  | 1,26 € | https://es.aliexpress.com/store/product/500Pcs-2012-Chip-resistor-1-4w-0805-5-0R-1-2-2-3-3-4-7/821060_32817289197.html
 | Resistencia 330 | 0,01 € | 3 | 0,04 € | 90,00 | 1,14 € |  |  | 1,26 € | https://es.aliexpress.com/store/product/500Pcs-2012-Chip-resistor-1-4w-0805-5-0R-1-2-2-3-3-4-7/821060_32817289197.html
 | Resistencia 1K | 0,01 € | 9 | 0,11 € | 270,00 | 3,41 € |  |  | 1,26 € | https://es.aliexpress.com/store/product/0805-SMD-Resistors-10k-10K-ohm-1-8W-5-0805-SMD-Resistors-0805-Chip-resistor-500pcs/821060_852348196.html
 | Resistencia 4K7 | 0,01 € | 2 | 0,03 € | 60,00 | 0,76 € |  |  | 1,26 € | https://es.aliexpress.com/store/product/0805-SMD-Resistors-10k-10K-ohm-1-8W-5-0805-SMD-Resistors-0805-Chip-resistor-500pcs/821060_852348196.html
 | Resistencia 10K | 0,01 € | 4 | 0,05 € | 120,00 | 1,52 € |  |  | 1,26 € | https://es.aliexpress.com/store/product/0805-SMD-Resistors-10k-10K-ohm-1-8W-5-0805-SMD-Resistors-0805-Chip-resistor-500pcs/821060_852348196.html
 | LED 1206 verm | 0,01 € | 1 | 0,01 € | 30,00 | 0,19 € |  |  | 0,65 € | https://es.aliexpress.com/store/product/100-unids-lote-3216-1206-SMD-Led-Super-brillante-rojo-Verde-azul-agua-clara-luz-LED/1326062_32889348579.html
 | LED 1206 verd | 0,01 € | 3 | 0,02 € | 90,00 | 0,49 € |  |  | 0,55 € | https://es.aliexpress.com/store/product/100-unids-lote-3216-1206-SMD-Led-Super-brillante-rojo-Verde-azul-agua-clara-luz-LED/1326062_32889348579.html
 | LED 1206 blau | 0,01 € | 2 | 0,01 € | 60,00 | 0,39 € |  |  | 0,66 € | https://es.aliexpress.com/store/product/100-unids-lote-3216-1206-SMD-Led-Super-brillante-rojo-Verde-azul-agua-clara-luz-LED/1326062_32889348579.html
 | LED 1206 blanc | 0,01 € | 3 | 0,02 € | 90,00 | 0,59 € |  |  | 0,66 € | https://es.aliexpress.com/store/product/100PCS-SMD-1206-White-Led-Free-Shipping-1206-smd-led-cool-white-Super-Bright-LED-Diode/1758868_32368682563.html
 | LED RGB 5mm | 0,04 € | 1 | 0,04 € | 30,00 | 1,19 € |  | 0,80 € |  | https://es.aliexpress.com/store/product/20pcs-5mm-RGB-LED-Common-Cathode-Tri-Color-Emitting-Diodes-f5-RGB-Diffused-5mm-led-red/1758868_32666259962.html
 | Display 0.96" | 1,94 € | 1 | 1,94 € | 30,00 | 58,17 € | 19,39 € |  |  | https://es.aliexpress.com/store/product/10pcs-0-96-blue-0-96-inch-OLED-module-New-128X64-OLED-LCD-LED-Display-Module/1022067_32640619833.html
 | Expansor pins mcp23017 | 0,93 € | 1 | 0,93 € | 30,00 | 27,84 € | 9,28 € |  |  | https://es.aliexpress.com/store/product/MCP23017-Serial-Interface-Module-IIC-I2C-SPI-MCP23S17-Bidirectional-16-Bit-I-O-Expander-Pins-10Mhz/1185416_32830799627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
 | Component | Preu ud | Qt | COST |  |  | Preu x10 | Preu x20 | Preu x100 | Link
 | SUMA | 23,26 € | 13 | 31,18 € | 300 | 697,77 € | - € | 56,84 € | - €
 | Rodes minisumo 33x20 | 0,66 € | 2 | 1,31 € | 0,00 | - € |  | 13,14 € |  | https://es.aliexpress.com/store/product/10-piezas-K346-43-19-3mm-d-hole-caucho-rueda-conveniente-para-N20-Motor-D-eje/1965526_32891298768.html
 | Sensor línia | 2,00 € | 3 | 6,00 € | 90,00 | 180,00 € |  |  |  | http://www.jsumo.com/micro-line-sensor-ml1
 | Sensor distància | 0,54 € | 3 | 1,62 € | 90,00 | 48,57 € |  |  |  | https://es.aliexpress.com/item/Smart-Electronics-New-for-Arduino-Diy-Smart-Car-Robot-Reflective-Photoelectric-3pin-IR-Infrared-Obstacle-Avoidance/32461659104.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
 | Start module | 5,50 € | 1 | 5,50 € | 30,00 | 165,00 € |  |  |  | http://www.jsumo.com/microstart-sumo-minisumo-robot-start-module
 | Bateria 2S 850mAh | 5,77 € | 1 | 5,77 € | 30,00 | 173,10 € |  |  |  | https://hobbyking.com/es_es/turnigy-nano-tech-850mah-2s-25-40c-lipo-pack.html
 | Carregador bateries | 6,61 € | 1 | 6,61 € | 0,00 | - € |  |  |  | https://hobbyking.com/es_es/hobbykingr-b3ac-compact-charger-eu-plug.html
 | Motors Pololu 1:50 | 2,19 € | 2 | 4,37 € | 60,00 | 131,10 € |  | 43,70 € |  | https://www.aliexpress.com/item/12MM-6V-300RPM-Powerful-High-Torque-DC-Gear-Box-Motor/32277738334.html
