dragonet80/MinisumoEdu/3D/RodaLlanda.stl

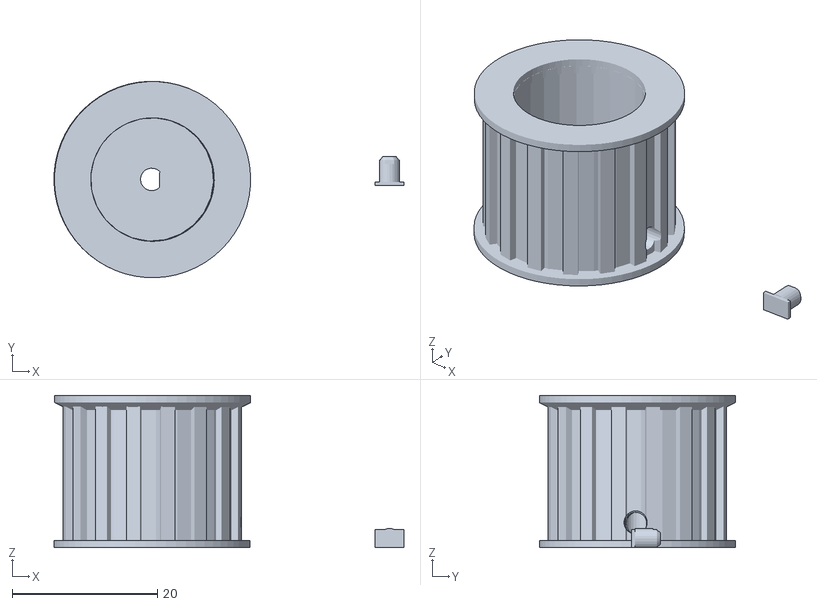
[picture p1: CAD file, 2019-02-02]
3D/RodaLlanda.stl
48.2 x 27.0 x 21.0
