dragonet80/MinisumoEdu/3D/SuportSensors45_triple.stl

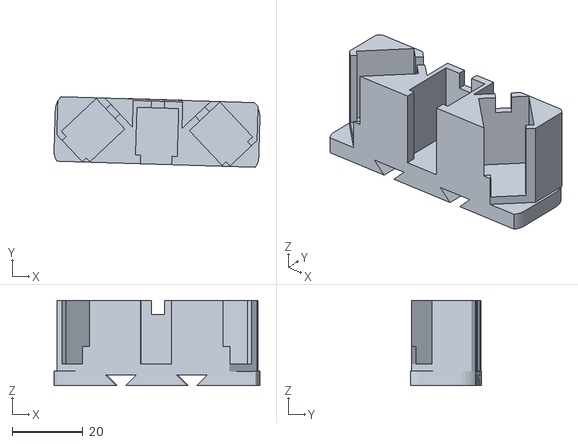
[picture p2: CAD file, 2019-02-02]
3D/SuportSensors45_triple.stl
58.2 x 19.9 x 24.0
