dragonet80/MinisumoEdu/3D/RampaNova.stl

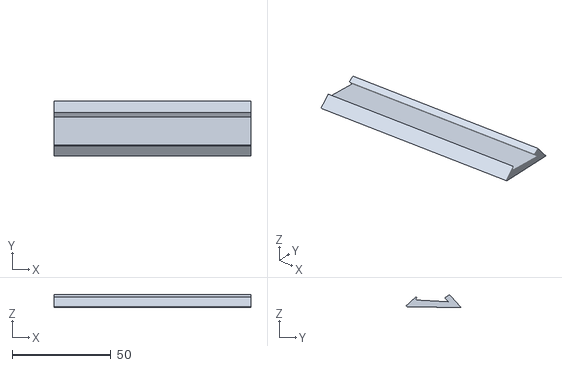
[picture p3: CAD file, 2019-02-02]
3D/RampaNova.stl
100.0 x 27.9 x 6.39
