dragonet80/MinisumoEdu/3D/RodaMotllo.stl

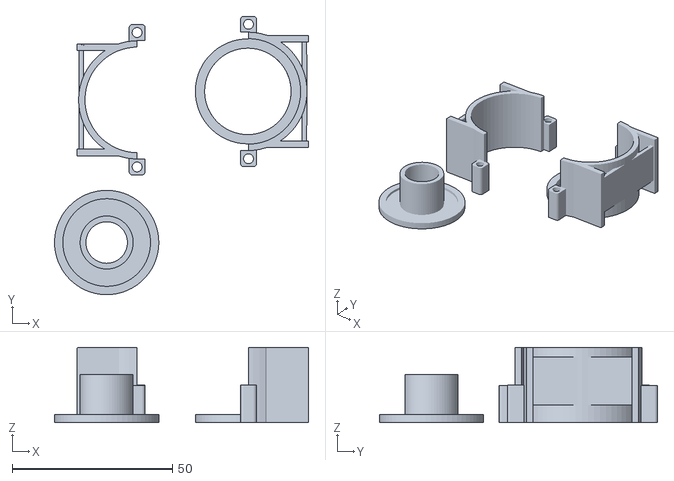
[picture p4: CAD file, 2019-02-02]
3D/RodaMotllo.stl
79.3 x 86.9 x 23.5
