dragonet80/MinisumoEdu/3D/Xassis.stl

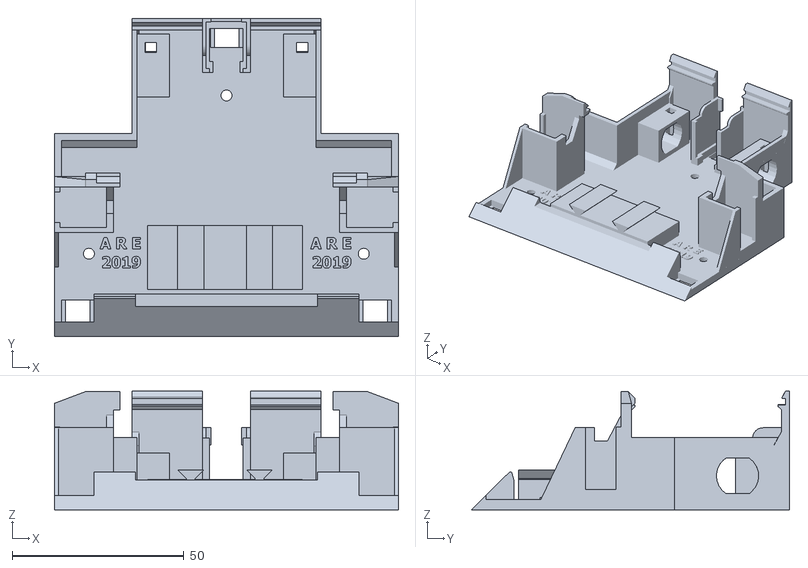
[picture p5: CAD file, 2019-02-02]
3D/Xassis.stl
100.0 x 92.5 x 34.6
