dragonet80/MinisumoEdu/3D/SuportSensors11_doble.stl

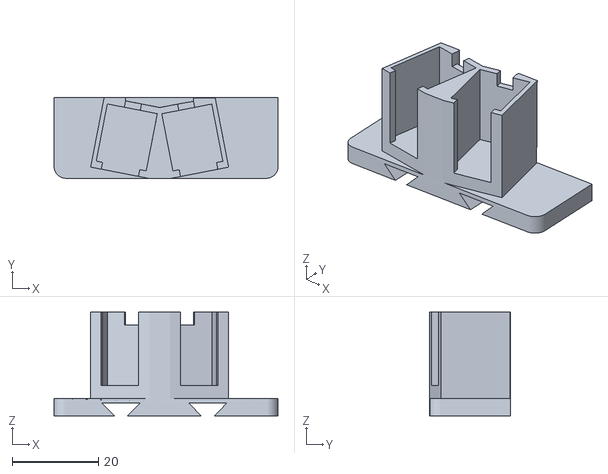
[picture p6: CAD file, 2019-02-02]
3D/SuportSensors11_doble.stl
51.9 x 18.8 x 24.0
