dragonet80/MinisumoEdu/3D/SuportSensors11_triple.stl

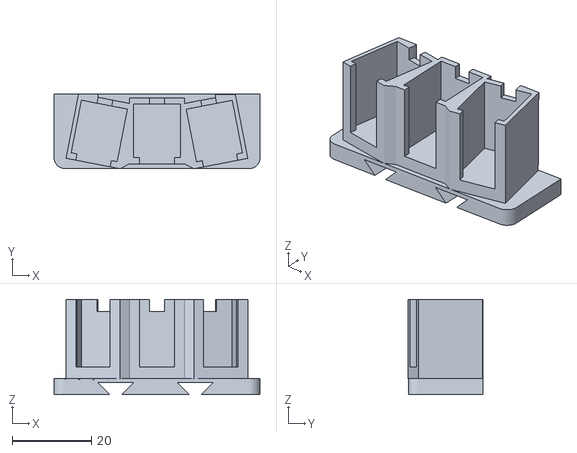
[picture p7: CAD file, 2018-10-21]
3D/SuportSensors11_triple.stl
51.9 x 18.8 x 24.0
