dragonet80/MinisumoEdu/3D/ClausRodes.stl

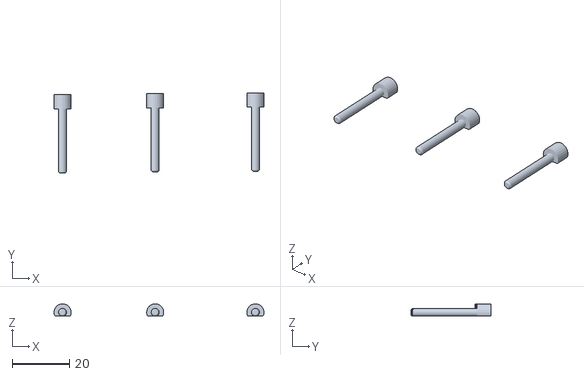
[picture p8: CAD file, 2018-10-21]
3D/ClausRodes.stl
73.6 x 28.2 x 4.35
