dragonet80/MinisumoEdu/3D/ClausMotors.stl

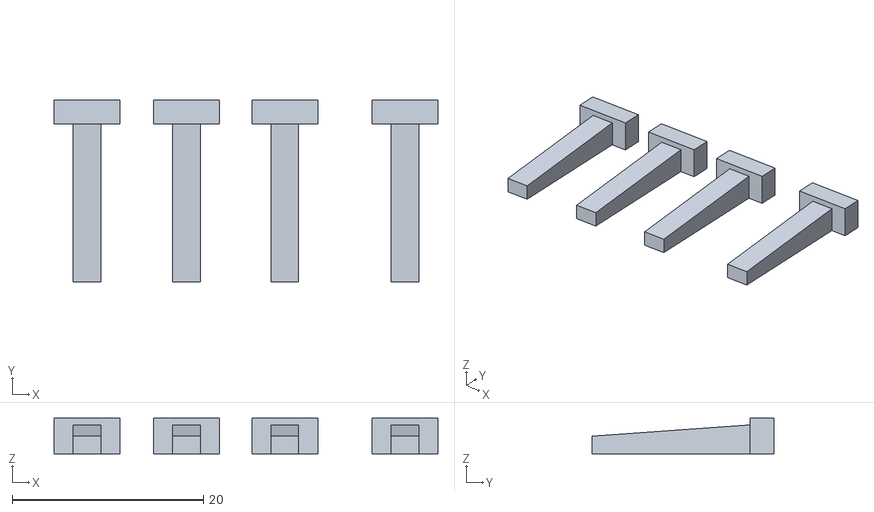
[picture p9: CAD file, 2018-10-21]
3D/ClausMotors.stl
40.2 x 19.0 x 3.72
