dragonet80/MinisumoEdu/3D/SuportSensors22_triple.stl

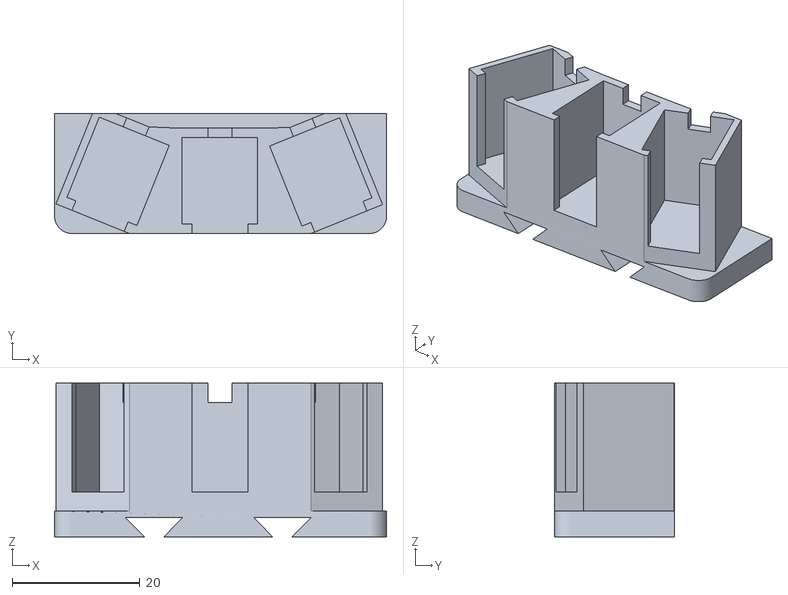
[picture p10: CAD file, 2018-10-21]
3D/SuportSensors22_triple.stl
51.9 x 18.8 x 24.0
