dragonet80/MinisumoEdu/Documents/Minisumo_Baix_sensecoure_nou.pdf

# C D CC BY⁻NC⁻SA CC BY⁻NC⁻SA

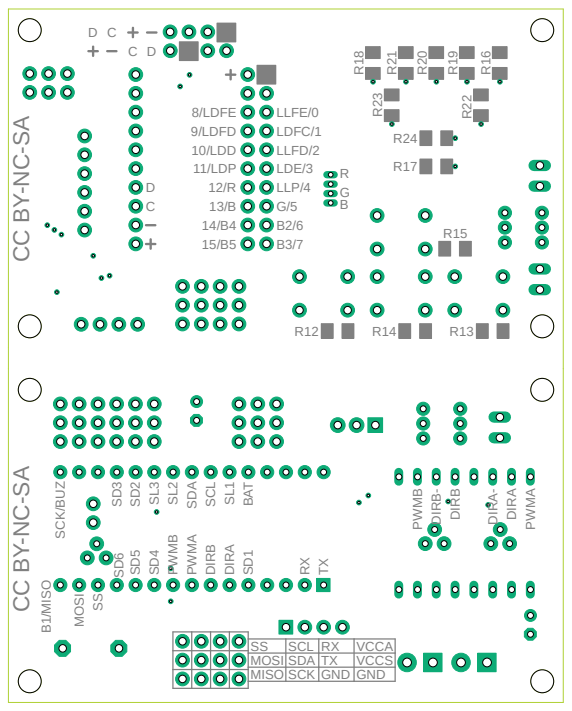
[picture p11: page 1]
R24 R¹⁸; R²¹; R²⁰; R¹⁹; R¹⁶ R²³; R²²; LLP/4; LDE/3; LLFD/2; LDFC/1; LLFE/0; PWMB; PWMA DIRB⁻ DIRB; DIRA⁻ DIRASD³ SD² SL3 SL2 SDA SCL SL1 BAT SCK/BUZ B¹/MISO; MOSI SS SD⁶ SD⁵ SD⁴ PWMB PWMA DIRB DIRA SD¹; RXTX; 11/LDP; 10/LDD; 9/LDFD; 8/LDFE

SS | SCL | RX | VCCA
MOSI | SDA | TX | VCCS
MISO | SCK | GND | GND
