dragonet80/MinisumoEdu/Documents/Minisumo_Dalt_sensecoure_nou.pdf

F
R29 | R28 ARDUINO NANO | CC BY-NC-SA CC BY⁻NC⁻SA BAT OUT | On/Off | MCP²³⁰¹⁷

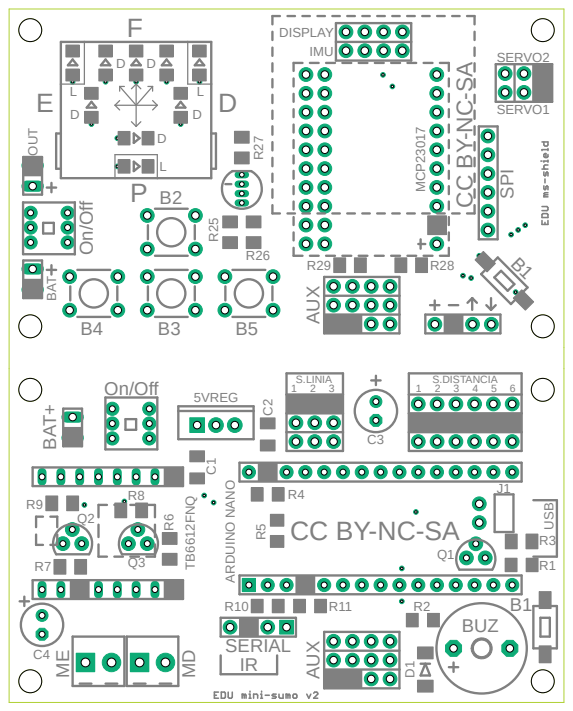
[picture p12: page 1]
