dragonet80/MinisumoEdu/PCB_Minisumo_2018_Educatiu.brd

## EAGLE design PCB_Minisumo_2018_Educatiu.brd (2018-12-02)

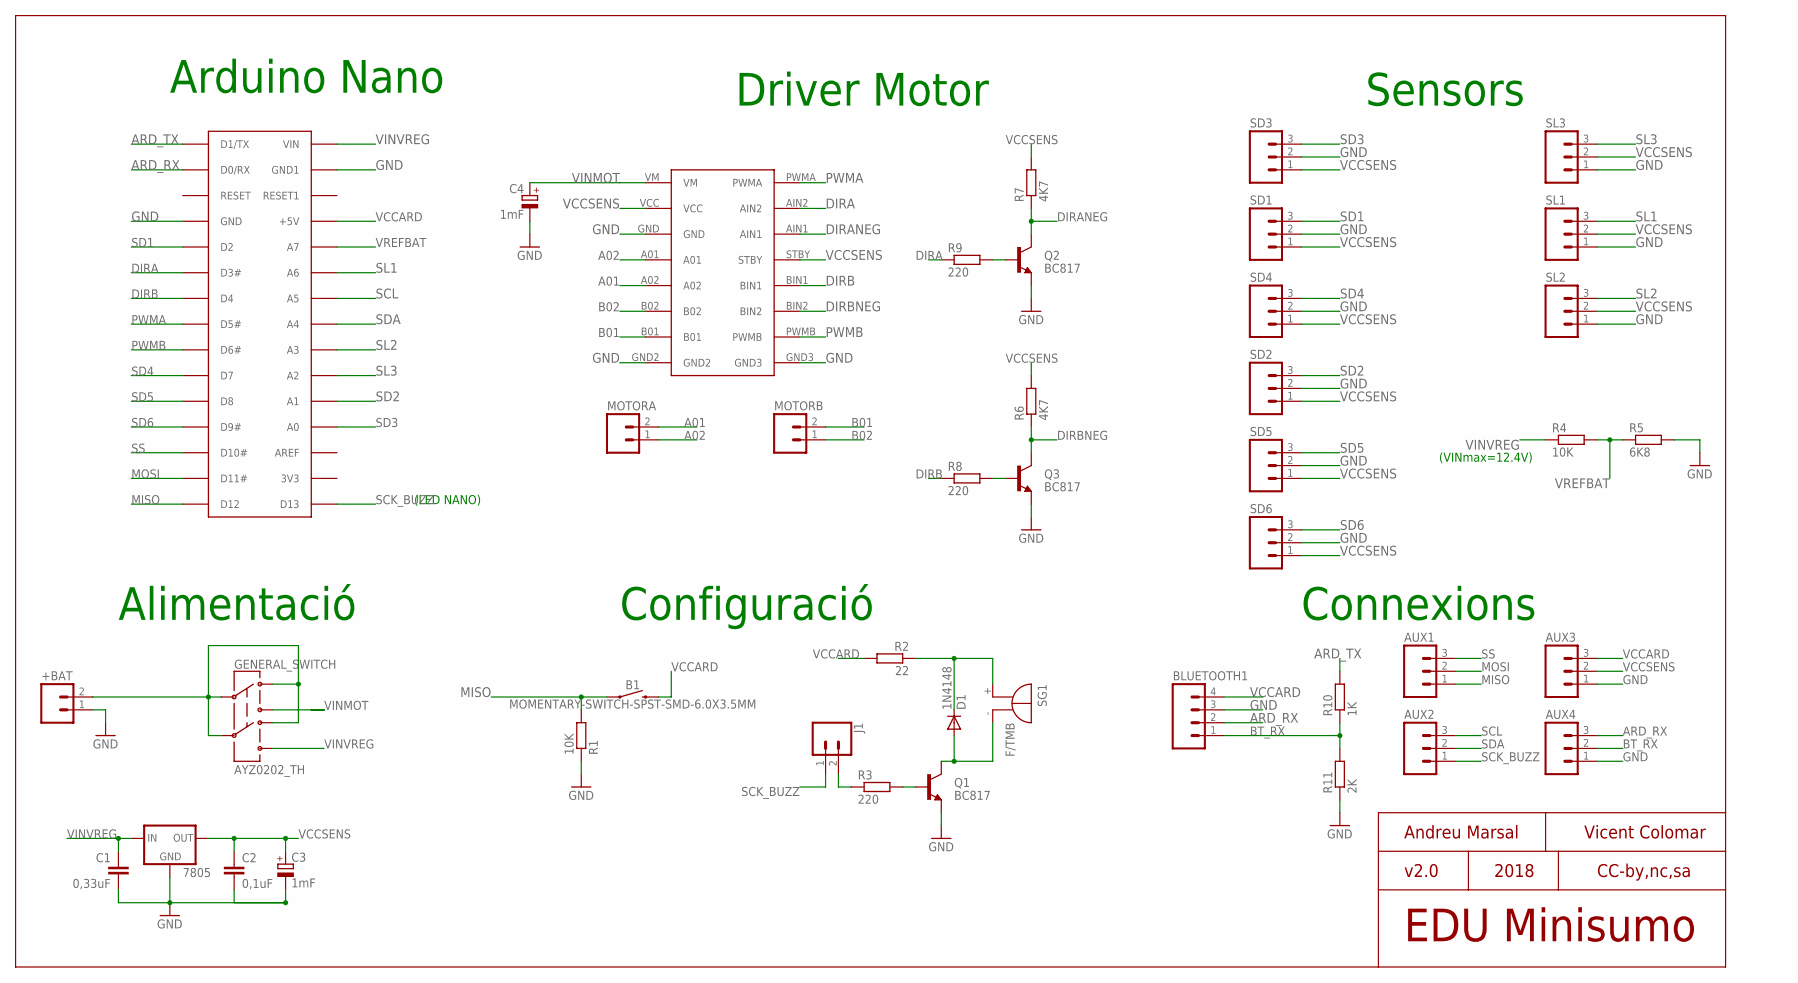
[picture p13: schematic PCB_Minisumo_2018_Educatiu.sch, sheet 1]

Parts:
7805: V_REG_78XXSINK; TO220-IGO
+BAT: M02LOCK_LONGPADS; 1X02_LOCK_LONGPADS
AUX1, AUX2, AUX3, AUX4: M03PTH; 1X03
B1: MOMENTARY-SWITCH-SPST-SMD-6.0X3.5MM; TACTILE_SWITCH_SMD_6.0X3.5MM
BLUETOOTH1: M04PTH; 1X04
C1: 0,33uF; C1206K
C2: 0,1uF; C1206K
C3, C4: 1mF; E2,5-6
D1: 1N4148; SOD106-R
GENERAL_SWITCH: AYZ0202_TH
J1: CONN_02; 1X02
MOTORA: M023.5MM; SCREWTERMINAL-3.5MM-2
MOTORB: M023.5MM; SCREWTERMINAL-3.5MM-2
Q1, Q2, Q3: BC817; TO-92
R1, R4: 10K; R1206
R2: 22; R1206
R3, R8, R9: 220; M1206
R5: 6K8; R1206
R6, R7: 4K7; M1206
R10: 1K; R1206
R11: 2K; R1206
SD1, SD2, SD3, SD4, SD5, SD6: M03PTH; 1X03
SG1: F/TMB
SL1, SL2, SL3: M03PTH; 1X03
U$1: ARDUINONANONOHOLES; PDIP-32NOHOLES
U$2: TB6612FNG_SPARKFUN

Connections:
A01: MOTORA.2, U$2.A02
A02: MOTORA.1, U$2.A01
ARD_RX: AUX4.3, BLUETOOTH1.2, U$1.D0/RX; also elsewhere on the board
ARD_TX: R10.2, U$1.D1/TX; also elsewhere on the board
B01: MOTORB.2, U$2.B01
B02: MOTORB.1, U$2.B02
BT_RX: AUX4.2, BLUETOOTH1.1, R10.1, R11.2
DIRA: R9.1, U$1.D3 (D3#), U$2.AIN2
DIRANEG: Q2.3 (C), R7.1, U$2.AIN1
DIRB: R8.1, U$1.D4, U$2.BIN1
DIRBNEG: Q3.3 (C), R6.1, U$2.BIN2
GND: 7805.GND, +BAT.1, AUX3.1, AUX4.1, BLUETOOTH1.3, C1.2, C2.2, C3.-, C4.-, Q1.1 (E), Q2.1 (E), Q3.1 (E), R1.1, R5.2, R11.1, SD1.2, SD2.2, SD3.2, SD4.2, SD5.2, SD6.2, SL1.1, SL2.1, SL3.1, U$1.GND, U$1.GND1, U$2.GND, U$2.GND2, U$2.GND3; also elsewhere on the board
MISO: AUX1.1, B1.1, R1.2, U$1.D12; also elsewhere on the board
MOSI: AUX1.2, U$1.D11 (D11#); also elsewhere on the board
unnamed: J1.2, R3.1
unnamed: Q1.2 (B), R3.2
unnamed: D1.A, Q1.3 (C), SG1.-
unnamed: Q2.2 (B), R9.2
unnamed: D1.C, R2.1, SG1.+
unnamed: Q3.2 (B), R8.2
PWMA: U$1.D5 (D5#), U$2.PWMA
PWMB: U$1.D6 (D6#), U$2.PWMB
SCK_BUZZ: AUX2.1, J1.1, U$1.D13; also elsewhere on the board
SCL: AUX2.3, U$1.A5; also elsewhere on the board
SD1: SD1.3, U$1.D2
SD2: SD2.3, U$1.A1
SD3: SD3.3, U$1.A0
SD4: SD4.3, U$1.D7
SD5: SD5.3, U$1.D8
SD6: SD6.3, U$1.D9 (D9#)
SDA: AUX2.2, U$1.A4; also elsewhere on the board
SL1: SL1.3, U$1.A6
SL2: SL2.3, U$1.A3
SL3: SL3.3, U$1.A2
SS: AUX1.3, U$1.D10 (D10#); also elsewhere on the board
VBAT: +BAT.2, GENERAL_SWITCH.C1, GENERAL_SWITCH.C2, GENERAL_SWITCH.D1, GENERAL_SWITCH.D2
VCCARD: AUX3.3, B1.2, BLUETOOTH1.4, R2.2, U$1.+5V; also elsewhere on the board
VCCSENS: 7805.OUT, AUX3.2, C2.1, C3.+, R6.2, R7.2, SD1.1, SD2.1, SD3.1, SD4.1, SD5.1, SD6.1, SL1.2, SL2.2, SL3.2, U$2.STBY, U$2.VCC; also elsewhere on the board
VINMOT: C4.+, GENERAL_SWITCH.B1, U$2.VM
VINVREG: 7805.IN, C1.1, GENERAL_SWITCH.B2, R4.1, U$1.VIN; also elsewhere on the board
VREFBAT: R4.2, R5.1, U$1.A7

Notes on the sheet:
Alimentació
Configuració
Arduino Nano
Driver Motor
(VINmax=12.4V)
Sensors
(LED NANO)
EDU Minisumo
v2.0
2018
CC-by,nc,sa
Andreu Marsal
Vicent Colomar
Connexions

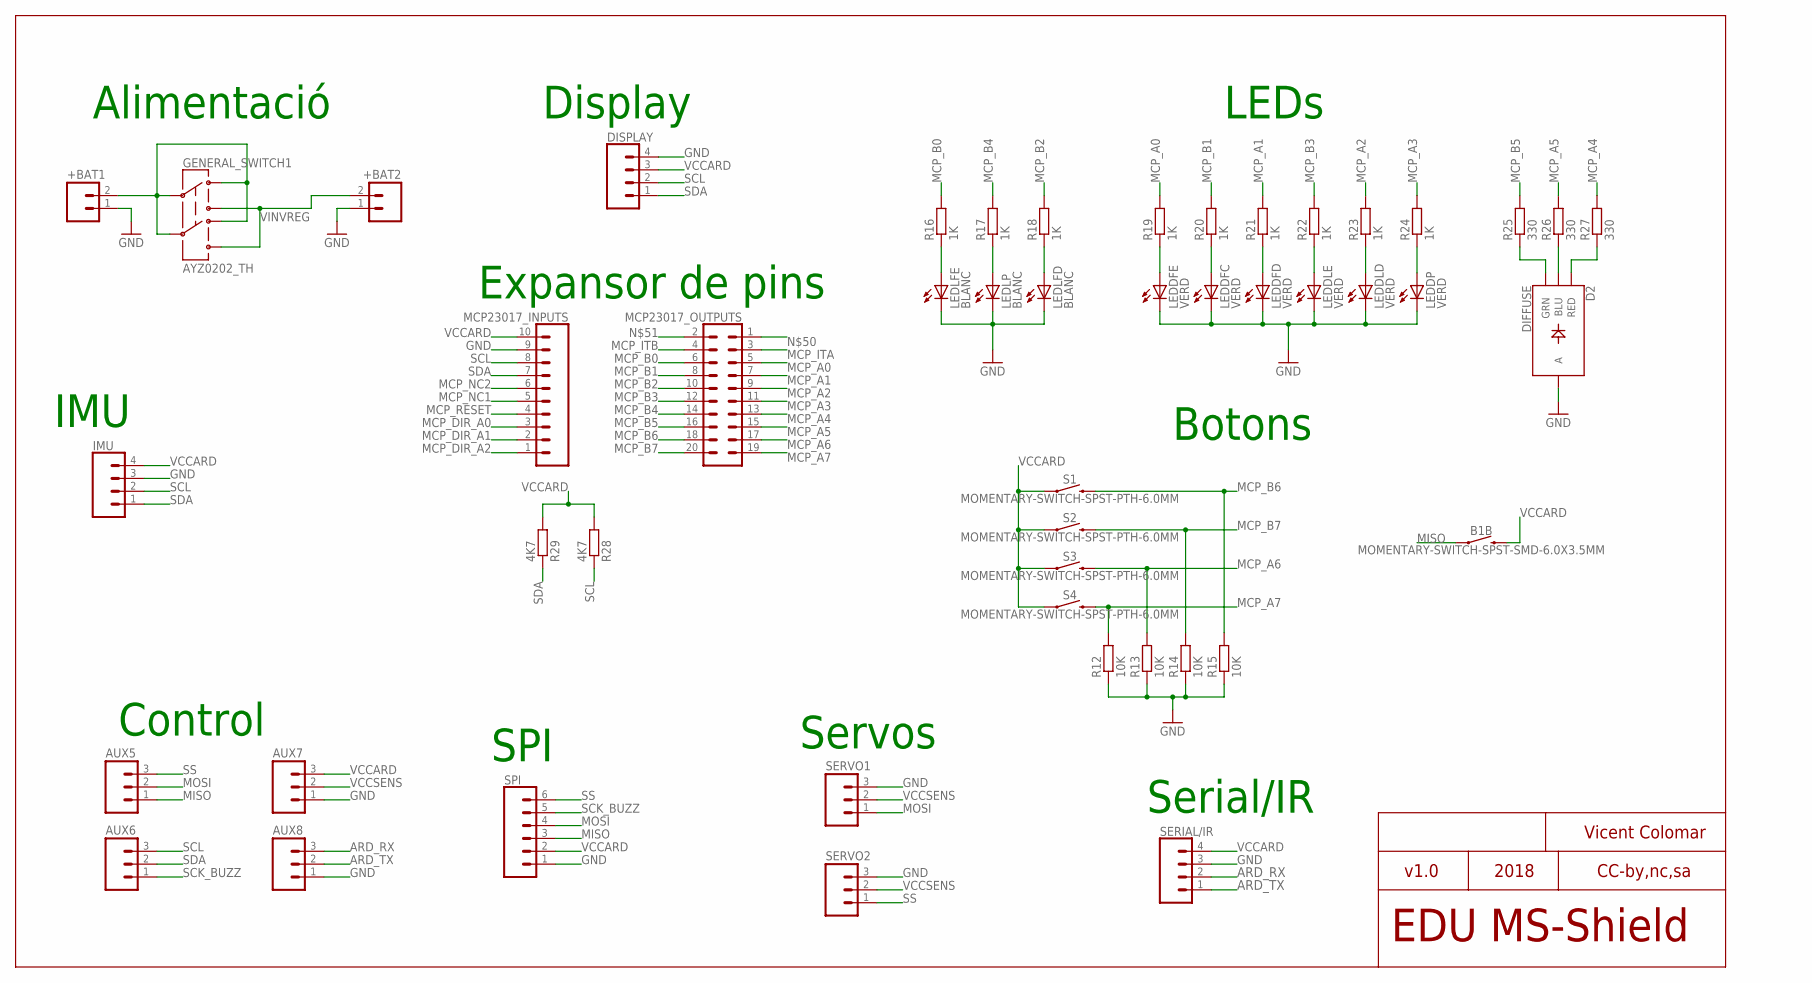
[picture p14: schematic PCB_Minisumo_2018_Educatiu.sch, sheet 2]

Parts:
+BAT1, +BAT2: M02LOCK_LONGPADS; 1X02_LOCK_LONGPADS
AUX5, AUX6, AUX7, AUX8: M03PTH; 1X03
B1B: MOMENTARY-SWITCH-SPST-SMD-6.0X3.5MM; TACTILE_SWITCH_SMD_6.0X3.5MM
D2: DIFFUSE; LED-RGB-THRU
DISPLAY: CONN_04; 1X04
GENERAL_SWITCH1: AYZ0202_TH
IMU: CONN_04; 1X04
LEDDFC: VERD; 1206
LEDDFD: VERD; 1206
LEDDFE: VERD; 1206
LEDDLD: VERD; 1206
LEDDLE: VERD; 1206
LEDDP: VERD; 1206
LEDLFD: BLANC; 1206
LEDLFE: BLANC; 1206
LEDLP: BLANC; 1206
MCP23017_INPUTS: CONN_10"; 1X10
MCP23017_OUTPUTS: CONN_10X2; 2X10
R12, R13, R14, R15: 10K; M1206
R16, R17, R18, R19, R20, R21, R22, R23, R24: 1K; M1206
R25, R26, R27: 330; M1206
R28, R29: 4K7; M1206
S1, S2, S3, S4: MOMENTARY-SWITCH-SPST-PTH-6.0MM; TACTILE_SWITCH_PTH_6.0MM
SERIAL/IR: CONN_04; 1X04
SERVO1, SERVO2: M03PTH; 1X03
SPI: CONN_06SILK_FEMALE_PTH; 1X06

Connections:
ARD_RX: AUX8.3, SERIAL/IR.2; also elsewhere on the board
ARD_TX: AUX8.2, SERIAL/IR.1; also elsewhere on the board
GND: +BAT1.1, +BAT2.1, AUX7.1, AUX8.1, D2.2 (A), DISPLAY.4, IMU.3, LEDDFC.C, LEDDFD.C, LEDDFE.C, LEDDLD.C, LEDDLE.C, LEDDP.C, LEDLFD.C, LEDLFE.C, LEDLP.C, MCP23017_INPUTS.9, R12.1, R13.1, R14.1, R15.1, SERIAL/IR.3, SERVO1.3, SERVO2.3, SPI.1; also elsewhere on the board
MCP_A0: MCP23017_OUTPUTS.5, R19.2
MCP_A1: MCP23017_OUTPUTS.7, R21.2
MCP_A2: MCP23017_OUTPUTS.9, R23.2
MCP_A3: MCP23017_OUTPUTS.11, R24.2
MCP_A4: MCP23017_OUTPUTS.13, R27.2
MCP_A5: MCP23017_OUTPUTS.15, R26.2
MCP_A6: MCP23017_OUTPUTS.17, R13.2, S3.3 (2)
MCP_A7: MCP23017_OUTPUTS.19, R12.2, S4.3 (2)
MCP_B0: MCP23017_OUTPUTS.6, R16.2
MCP_B1: MCP23017_OUTPUTS.8, R20.2
MCP_B2: MCP23017_OUTPUTS.10, R18.2
MCP_B3: MCP23017_OUTPUTS.12, R22.2
MCP_B4: MCP23017_OUTPUTS.14, R17.2
MCP_B5: MCP23017_OUTPUTS.16, R25.2
MCP_B6: MCP23017_OUTPUTS.18, R15.2, S1.3 (2)
MCP_B7: MCP23017_OUTPUTS.20, R14.2, S2.3 (2)
MCP_DIR_A0: MCP23017_INPUTS.3
MCP_DIR_A1: MCP23017_INPUTS.2
MCP_DIR_A2: MCP23017_INPUTS.1
MCP_ITA: MCP23017_OUTPUTS.3
MCP_ITB: MCP23017_OUTPUTS.4
MCP_NC1: MCP23017_INPUTS.5
MCP_NC2: MCP23017_INPUTS.6
MCP_RESET: MCP23017_INPUTS.4
MISO: AUX5.1, B1B.1, SPI.3; also elsewhere on the board
MOSI: AUX5.2, SERVO1.1, SPI.4; also elsewhere on the board
unnamed: D2.3 (GRN), R25.1
unnamed: LEDLFE.A, R16.1
unnamed: LEDLP.A, R17.1
unnamed: LEDLFD.A, R18.1
unnamed: LEDDFE.A, R19.1
unnamed: LEDDFC.A, R20.1
unnamed: LEDDFD.A, R21.1
unnamed: LEDDLE.A, R22.1
unnamed: LEDDLD.A, R23.1
unnamed: LEDDP.A, R24.1
unnamed: D2.4 (BLU), R26.1
unnamed: D2.1 (RED), R27.1
SCK_BUZZ: AUX6.1, SPI.5; also elsewhere on the board
SCL: AUX6.3, DISPLAY.2, IMU.2, MCP23017_INPUTS.8, R28.1; also elsewhere on the board
SDA: AUX6.2, DISPLAY.1, IMU.1, MCP23017_INPUTS.7, R29.1; also elsewhere on the board
SS: AUX5.3, SERVO2.1, SPI.6; also elsewhere on the board
VBAT1: +BAT1.2, GENERAL_SWITCH1.C1, GENERAL_SWITCH1.C2, GENERAL_SWITCH1.D1, GENERAL_SWITCH1.D2
VCCARD: AUX7.3, B1B.2, DISPLAY.3, IMU.4, MCP23017_INPUTS.10, R28.2, R29.2, S1.1, S2.1, S3.1, S4.1, SERIAL/IR.4, SPI.2; also elsewhere on the board
VCCSENS: AUX7.2, SERVO1.2, SERVO2.2; also elsewhere on the board
VINVREG: +BAT2.2, GENERAL_SWITCH1.B1, GENERAL_SWITCH1.B2; also elsewhere on the board

Notes on the sheet:
EDU MS-Shield
2018
CC-by,nc,sa
Vicent Colomar
Alimentació
Display
Expansor de pins
Control
Serial/IR
Servos
LEDs
Botons
IMU
v1.0
SPI

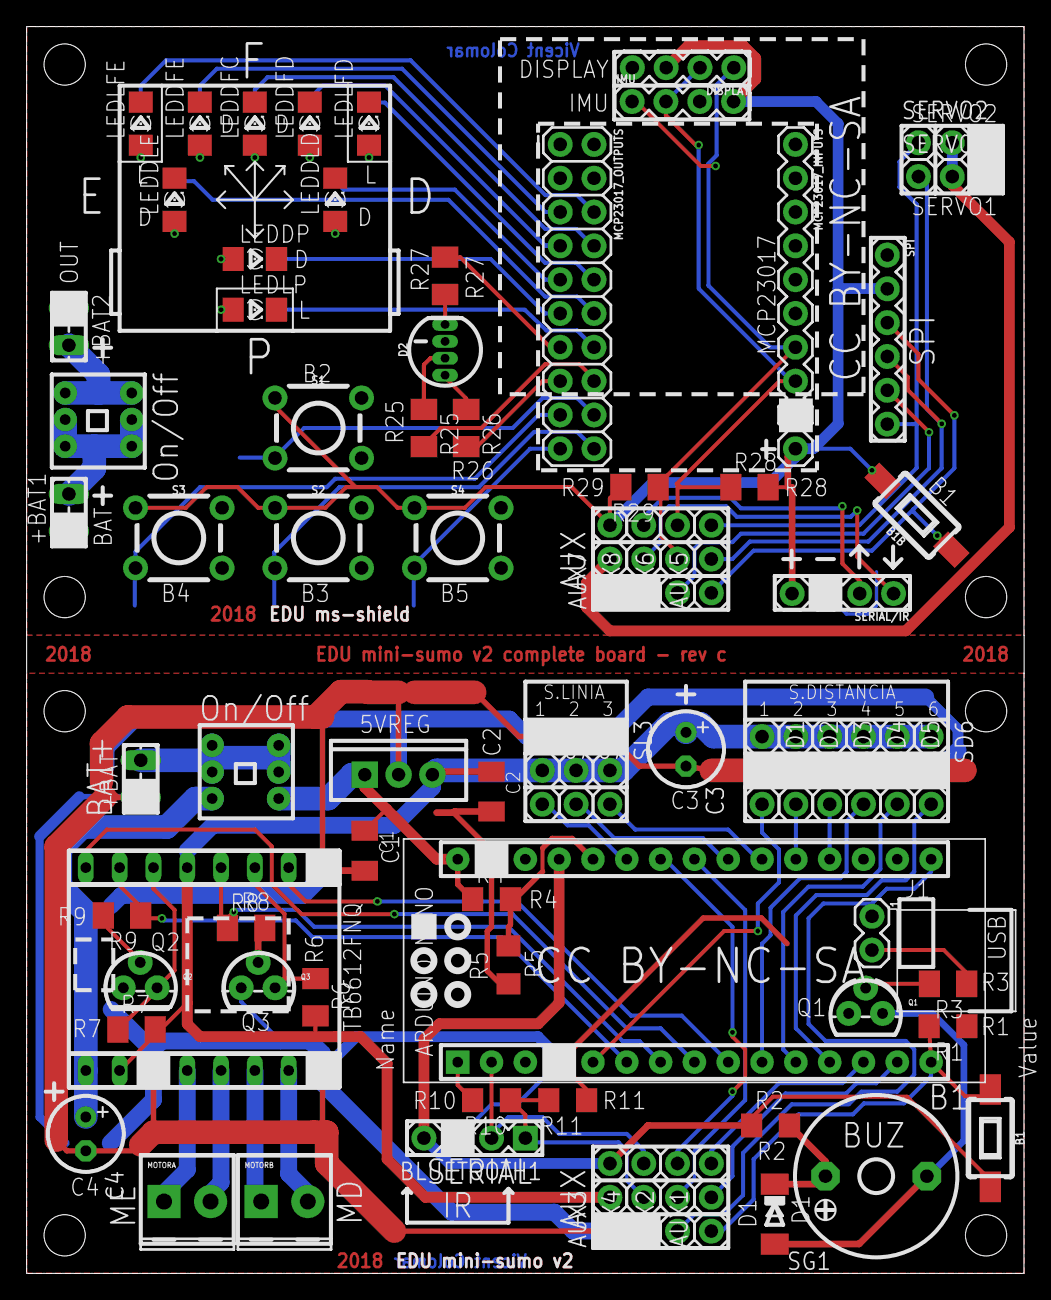
[picture p15: board PCB_Minisumo_2018_Educatiu.brd from above]

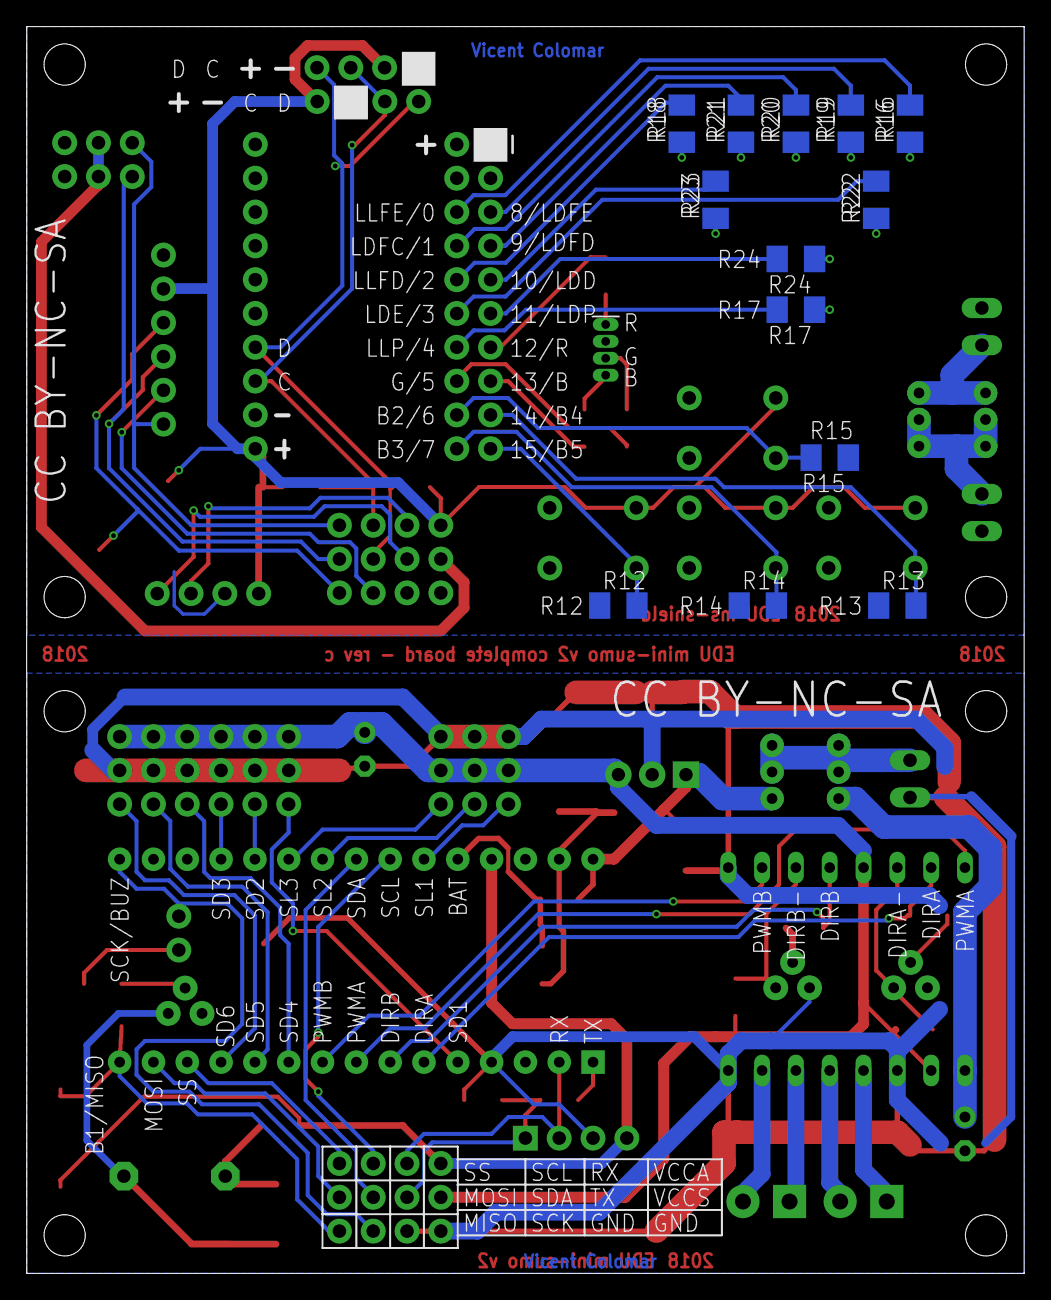
[picture p16: board PCB_Minisumo_2018_Educatiu.brd from below]

Board: 2 copper layers, 74.9 x 93.7 mm, 91 parts (13 on the bottom side), 70 nets.
