dragonet80/MinisumoEdu/(commit log)

2018-10-21 Create 3D-STL
2018-12-02 Add files via upload
    Corregits petits defectes en la placa.
    [PCB_Minisumo_2018_Educatiu.brd, PCB_Minisumo_2018_Educatiu.sch]
2019-02-02 Add files via upload
    Revisat i millorat el xassis.
    [ClausMotors.stl, ClausRodes.stl, RampaNova.stl, RodaLlanda.stl, RodaMotllo.stl, SuportSensors11_doble.stl, SuportSensors11_triple.stl, SuportSensors22_triple.stl]
2019-05-25 Ja funciona correctament
    S'han d'ajustar els valors de velocitats i girs.
    [Minisumo_ARE_Basic.ino]
